luanabuscariolo/bitvolts-o-meu-primeiro-robo/exemplos/README.md

# Exemplos

Programas curtos, um por teste. Cada um é independente: grave, observe, e passe ao seguinte só quando ele funcionar.

Os programas são os mesmos que estão impressos no livro, com um cabeçalho que lembra as ligações. Monte cada teste com a energia desligada e confira as ligações na figura indicada no cabeçalho antes de energizar.

| Pasta | Capítulo | O que testa |
|---|---|---|
| `cap04/primeiro_teste` | 4 | A placa grava e escreve no monitor série |
| `cap10/teste_display` | 10 · teste 2 | O display SH1106 |
| `cap10/teste_sensor` | 10 · teste 3 | O sensor HC-SR04, com o divisor do ECHO |
| `cap10/teste_servo` | 10 · teste 4 | O servo SG90 |
| `cap10/teste_buzzer` | 10 · teste 5 | O buzzer passivo |
| `cap10/teste_leds` | 10 · teste 6 | Os seis LEDs |
| `cap10/teste_motores` | 10 · teste 7 | Os motores pela ponte L298N — **rodas no ar** |
| `cap10/teste_bateria` | 10 · teste 9 | A leitura da bateria e a calibração |
| `cap13/estudar_led` | 13 | Um programa completo para ler e alterar |
| `cap15/teste_dois_nucleos` | 15 | Duas tarefas a correr em núcleos diferentes |
| `cap16/teste_fila` | 16 e 17 | A fila, o intervalo mínimo e a interrupção de uma frase |

`teste_dois_nucleos` e `teste_fila` não precisam de nenhum componente ligado — só a placa e o cabo USB. Servem para ver tarefas e filas a funcionar antes de chegar ao firmware completo.
