luanabuscariolo/bitvolts-o-meu-primeiro-robo/hardware/diagramas/divisor-bateria.png

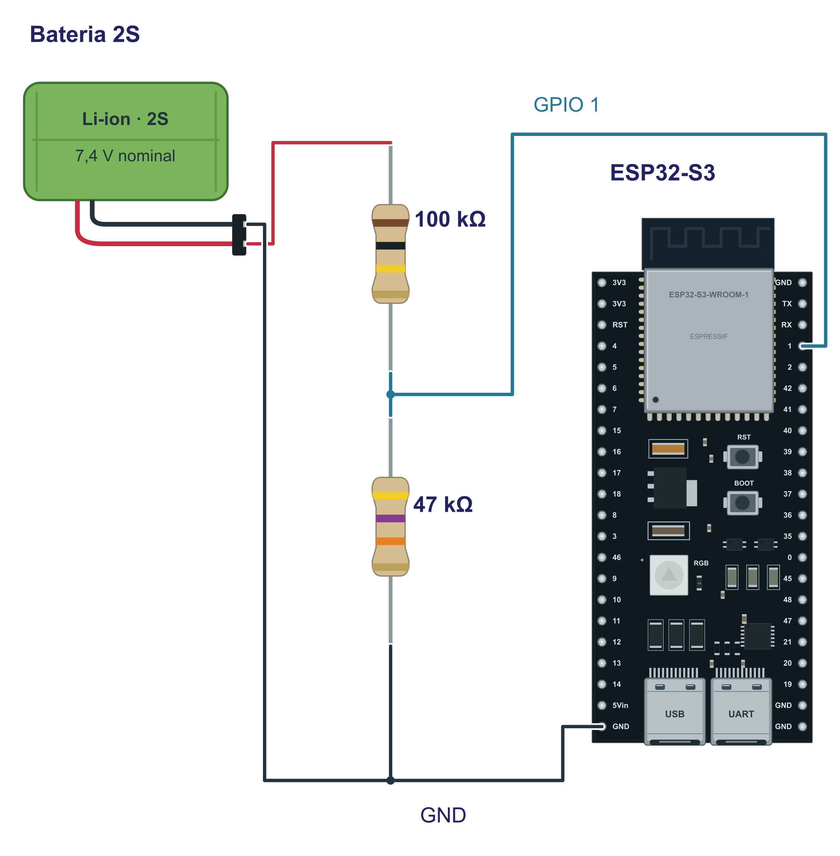
hardware/diagramas/divisor-bateria.png
