luanabuscariolo/bitvolts-o-meu-primeiro-robo/hardware/diagramas/mapa-alimentacao.png

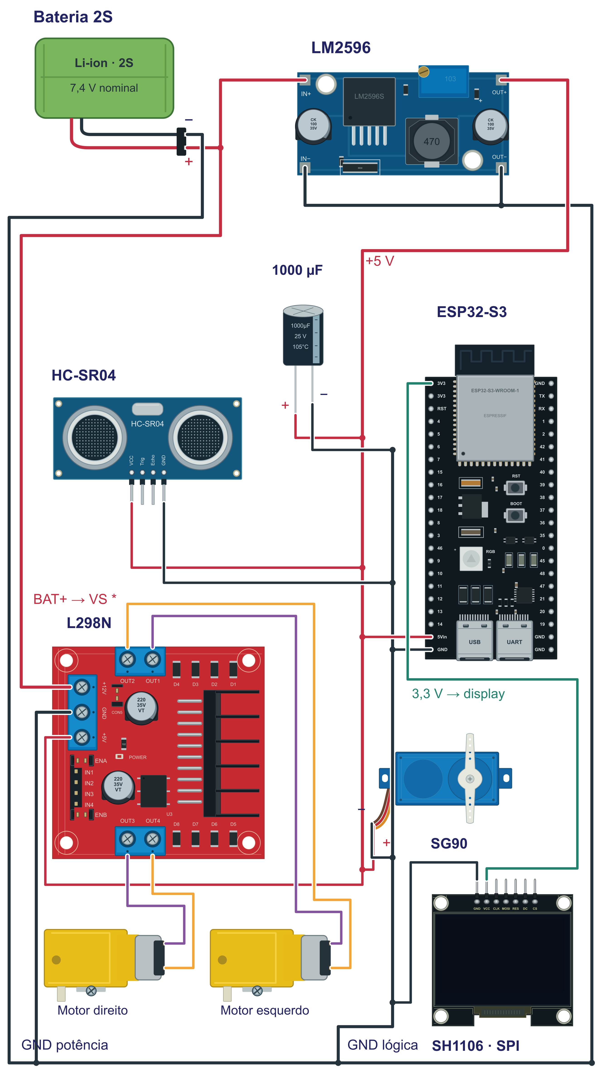
hardware/diagramas/mapa-alimentacao.png
