luanabuscariolo/bitvolts-o-meu-primeiro-robo/hardware/diagramas/mapa-sinais.png

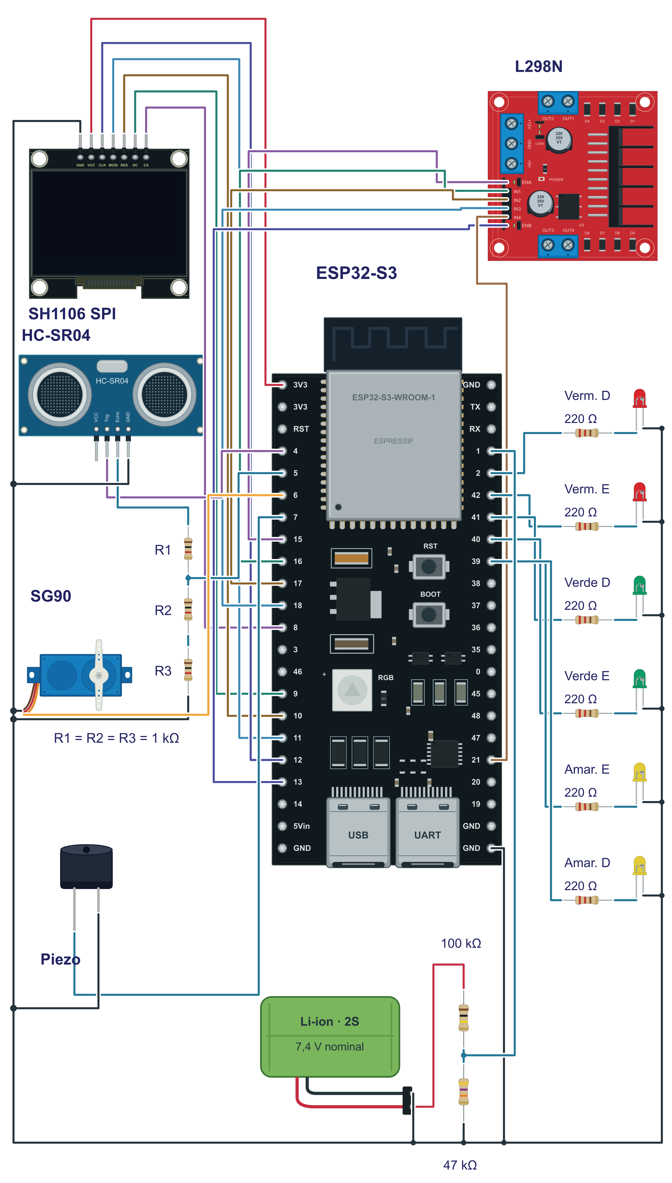
hardware/diagramas/mapa-sinais.png
