luanabuscariolo/bitvolts-o-meu-primeiro-robo/hardware/diagramas/pinagem.png

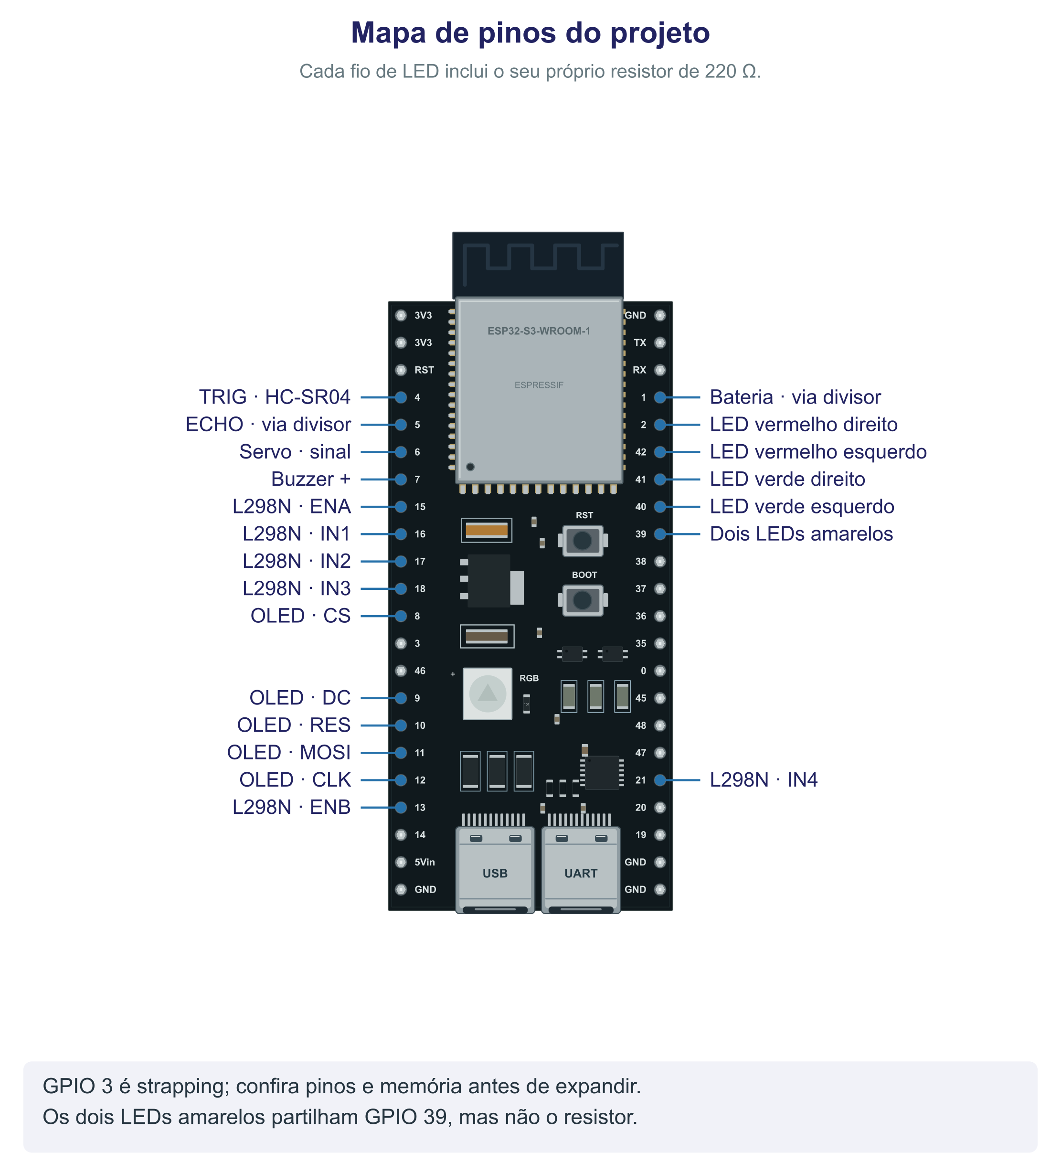
hardware/diagramas/pinagem.png
