luanabuscariolo/bitvolts-o-meu-primeiro-robo/hardware/diagramas/quatro-nos.png

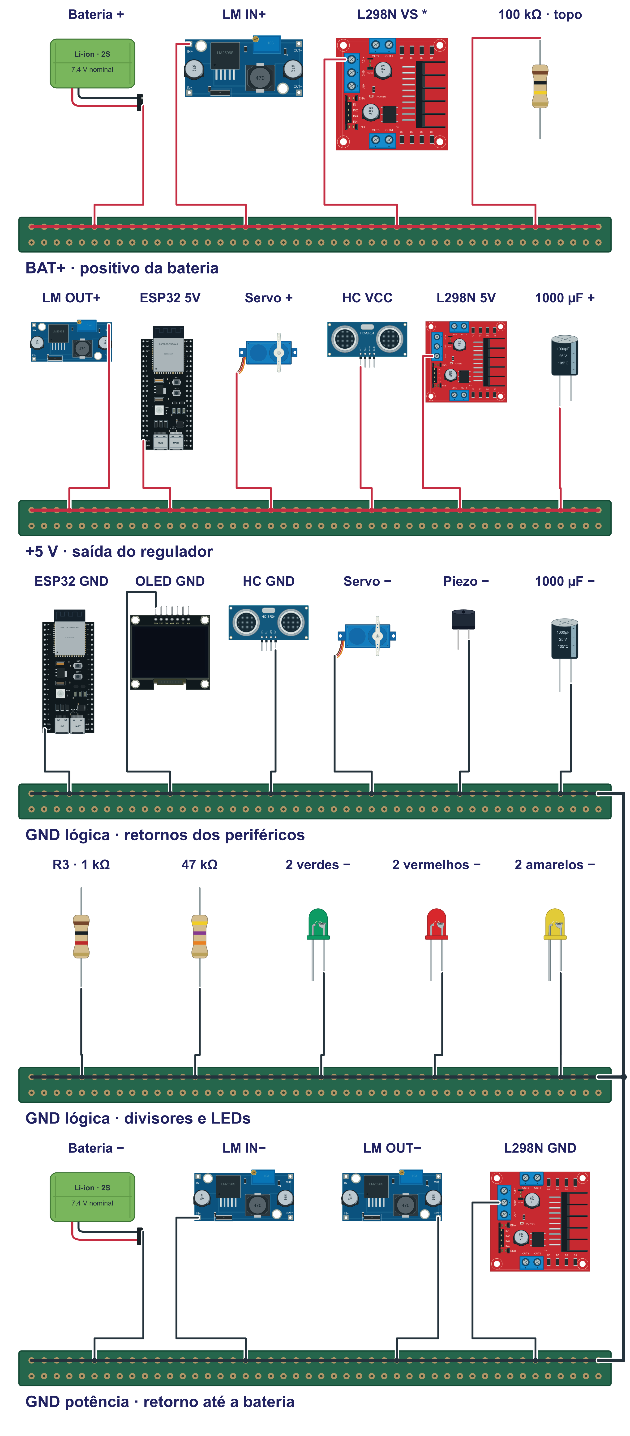
hardware/diagramas/quatro-nos.png
