luanabuscariolo/bitvolts-o-meu-primeiro-robo/hardware/diagramas/sensor-sem-solda.png

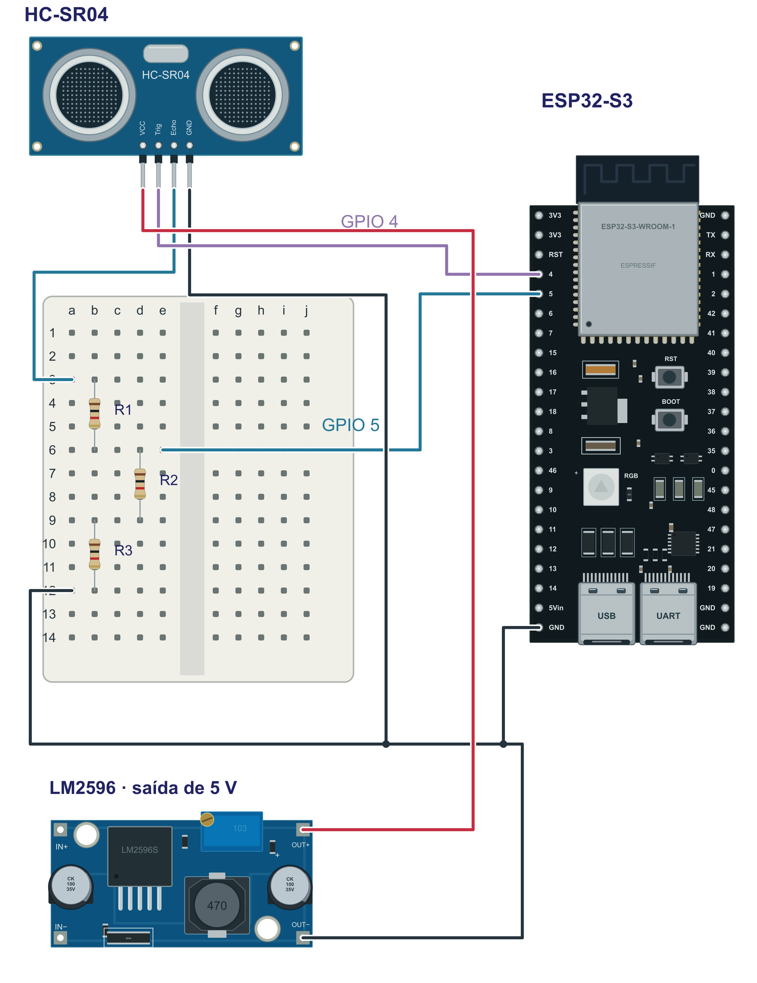
hardware/diagramas/sensor-sem-solda.png
