luanabuscariolo/bitvolts-o-meu-primeiro-robo/(commit log)

2026-10-10 Registrar material recebido sem alterações
2026-10-10 Corrigir eventos pendentes, frases e demonstração da fila
    [cerebro.ino, navegacao.ino, teste_fila.ino]
2026-10-10 Corrige diagnostico, arranque e referencias de montagem do livro
    [cerebro.ino, config.h, grump_v3.ino, navegacao.ino, teste_corpo_completo.ino, teste_servo.ino, tipos.h]
2026-10-10 Registra contexto da revisao, verificacoes e pendencias para Claude
2026-10-11 Remove adicoes de hardware nao autorizadas
2026-11-11 Passa frases, mensagens e documentação para português europeu
    Frases do robô e mensagens do monitor série em PT-PT; condensador e
    resistência em vez de capacitor e resistor na documentação. Sem
    alterações de lógica, pinos ou constantes.
    Claude-Session: https://claude.ai/code/session_01C2i5y8tvdGvzJPAQX2bmTm
2026-11-11 Remove do README a instrução de escolher a branch de correções
    A main já contém o código corrigido.
    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
